bveenema/DAF021_ECM_3G-Hardware/DAF021_ECM_3G.kicad_pcb

## KiCad design DAF021_ECM_3G.kicad_pcb (2020-06-30)

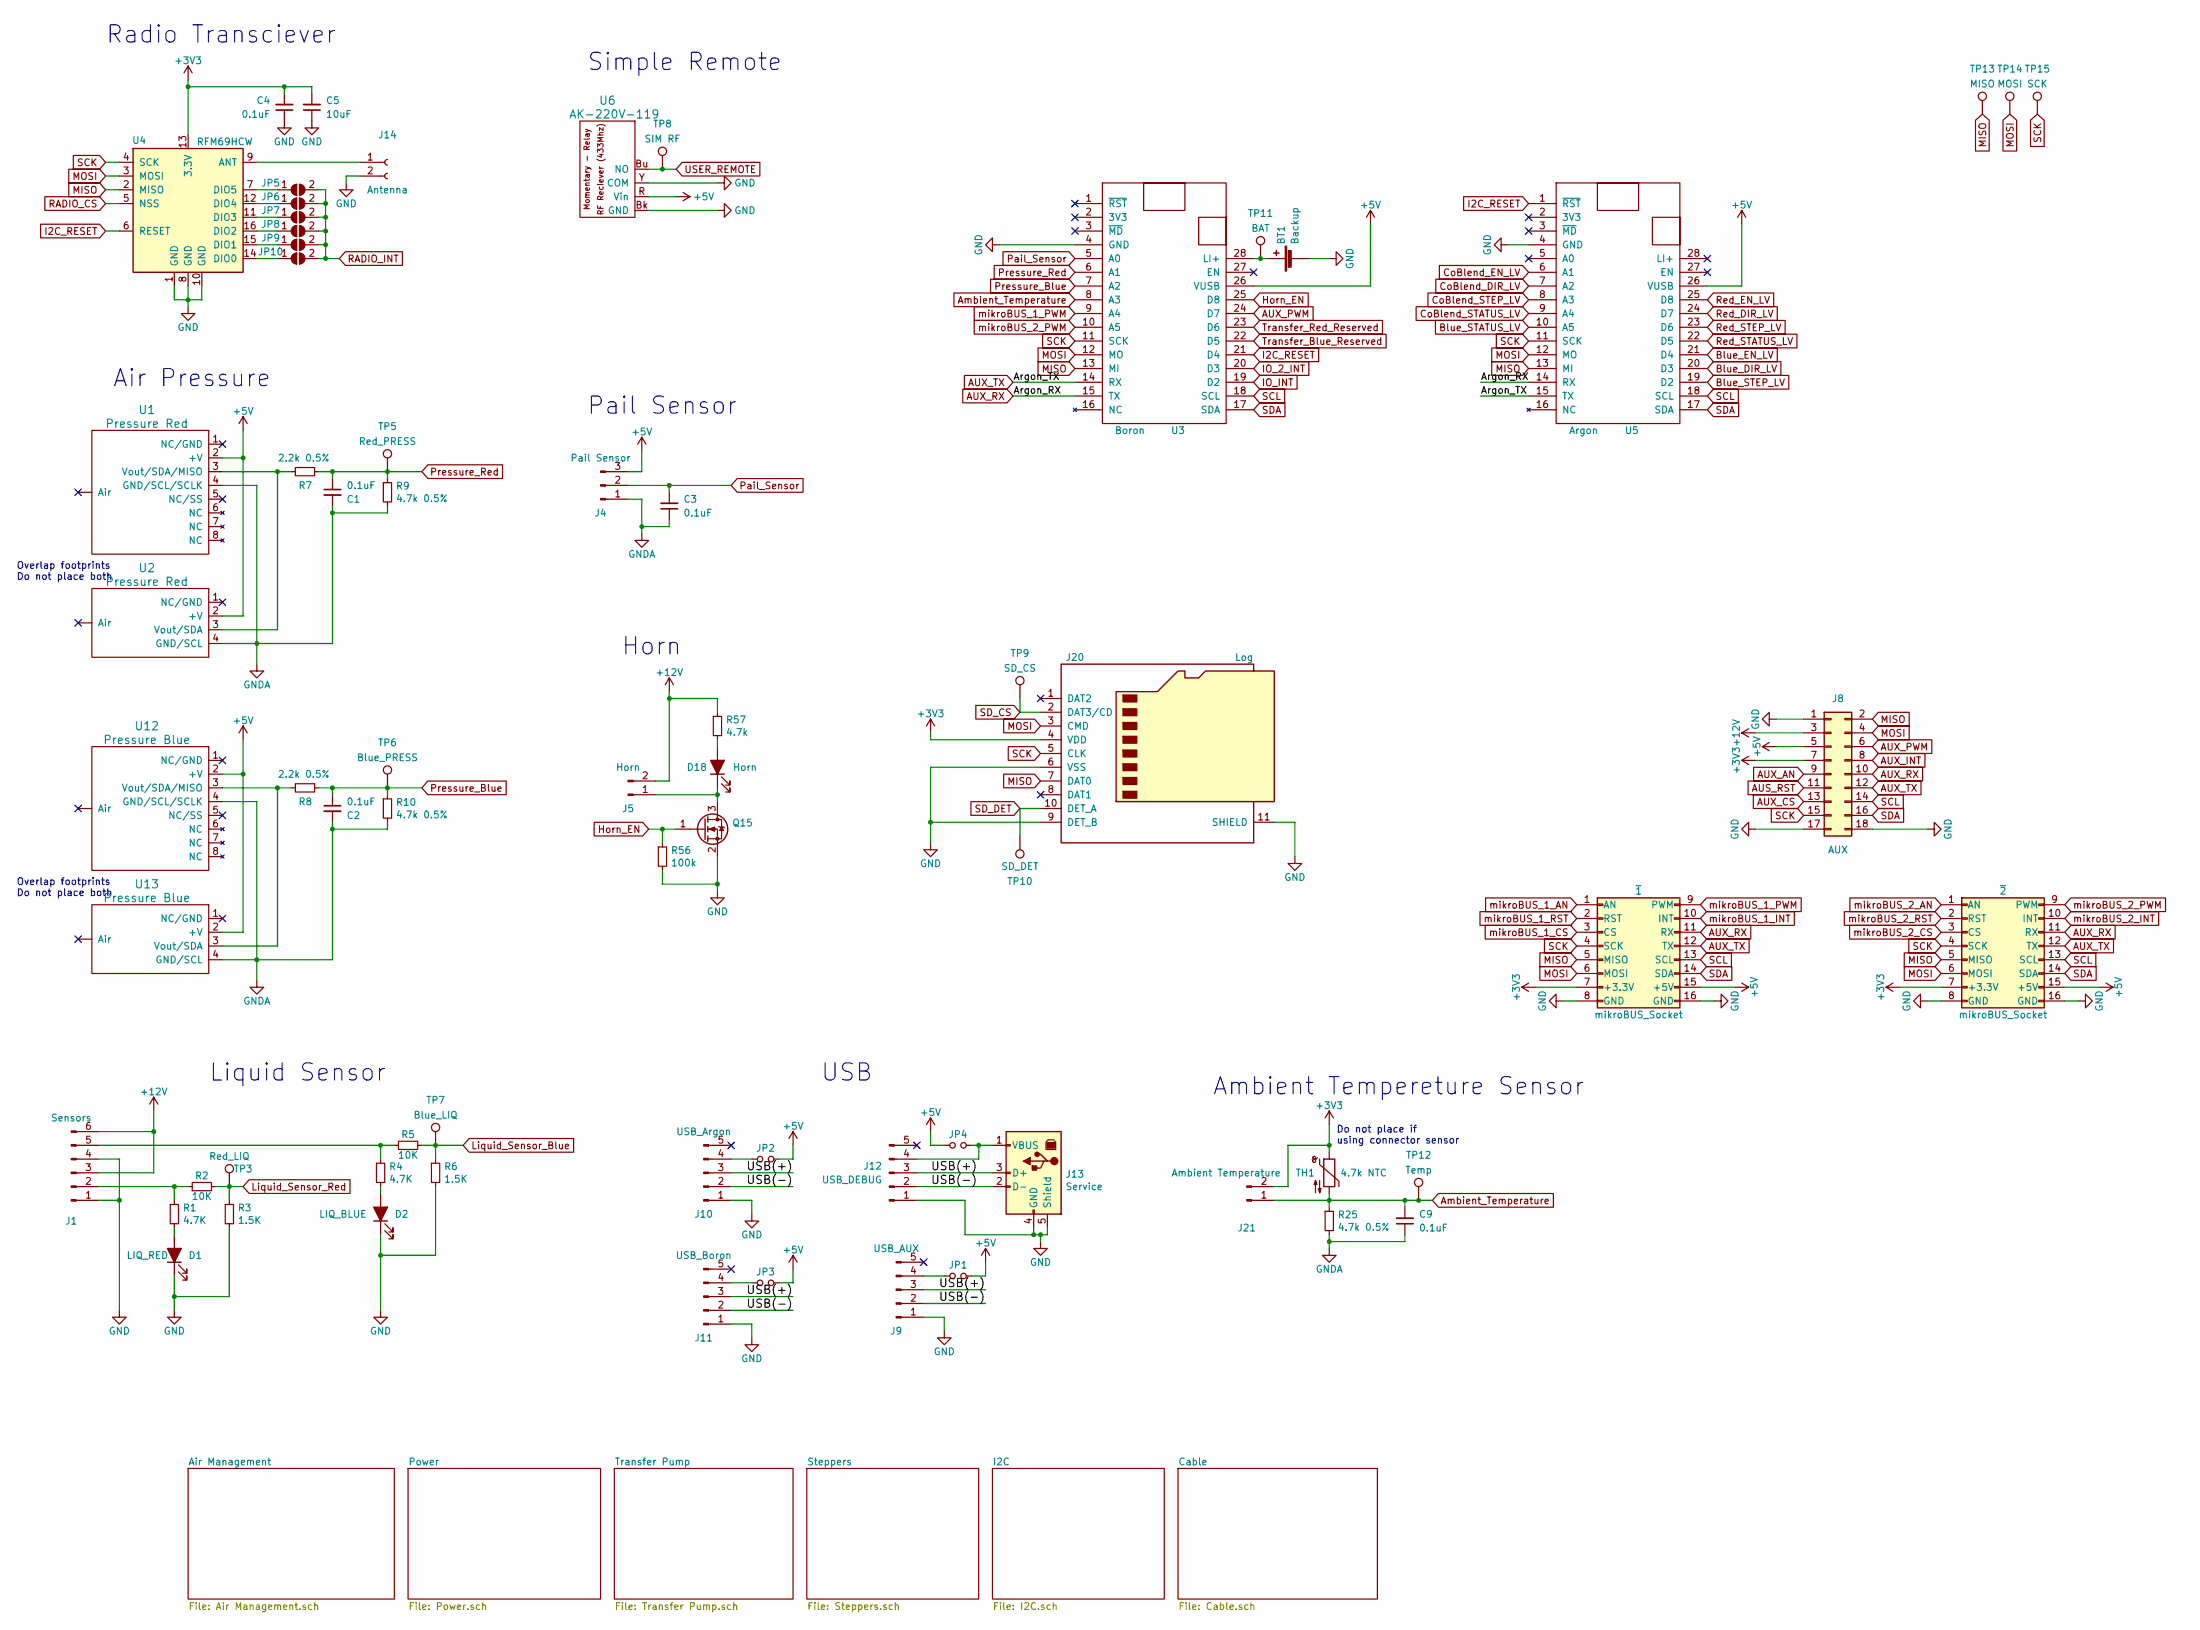
[picture p1: schematic DAF021_ECM_3G.sch]

Parts:
BT1: Backup; BatteryHolder_Keystone_1042_1x18650; MPN 1042
C1, C2, C3, C4, C9: 0.1uF; C_0805_2012Metric_Pad1.15x1.40mm_HandSolder; MPN CL21B104KCFWPNE
C5: 10uF; C_0805_2012Metric_Pad1.15x1.40mm_HandSolder; MPN CL21A106KOQNNNG
D1: LIQ_RED; LED_0805_2012Metric_Pad1.15x1.40mm_HandSolder; MPN 150080GS75000
D2: LIQ_BLUE; LED_0805_2012Metric_Pad1.15x1.40mm_HandSolder; MPN 150080GS75000
D18: Horn; LED_0805_2012Metric_Pad1.15x1.40mm_HandSolder; MPN 150080GS75000
J1: Sensors; JST_XH_B6B-XH-AM_1x06_P2.50mm_Vertical; MPN B6B-XH-AM(LF)(SN)
J4: Pail Sensor; JST_XH_B3B-XH-AM_1x03_P2.50mm_Vertical; MPN B3B-XH-AM(LF)(SN)
J5: Horn; JST_XH_B2B-XH-AM_1x02_P2.50mm_Vertical; MPN B2B-XH-A(LF)(SN)
J8: AUX; JST_XAD_B18B-XADSS-N-A_2x09_P2.50mm_Vertical; MPN B18B-XADSS-N(LF)(SN)
J9: USB_AUX; JST_XH_B5B-XH-AM_1x05_P2.50mm_Vertical; MPN B5B-XH-AM(LF)(SN)
J10: USB_Argon; JST_XH_B5B-XH-AM_1x05_P2.50mm_Vertical; MPN B5B-XH-AM(LF)(SN)
J11: USB_Boron; JST_XH_B5B-XH-AM_1x05_P2.50mm_Vertical; MPN B5B-XH-AM(LF)(SN)
J12: USB_DEBUG; JST_XH_B5B-XH-AM_1x05_P2.50mm_Vertical; MPN B5B-XH-AM(LF)(SN)
J13: Service; USB_B_Molex_67068-8000_Horizontal; MPN 0670688000
J14: Antenna; U.FL_Hirose_U.FL-R-SMT-1_Vertical; MPN U.FL-R-SMT-1(01)
J20: Log; microSD_HC_Hirose_DM3D-SF; MPN DM3D-SF
J21: Ambient Temperature; JST_XH_B2B-XH-AM_1x02_P2.50mm_Vertical; MPN B2B-XH-A(LF)(SN)
JP1, JP2, JP3, JP4, JP5, JP6, JP7, JP8, JP9, JP10: Jumper_NO_Small; SolderJumper-2_P1.3mm_Open_TrianglePad1.0x1.5mm; MPN N/A
Q15: Q_NMOS_GSD; SOT-23; MPN DMN3404L-7
R1, R4: 4.7K; R_0805_2012Metric_Pad1.15x1.40mm_HandSolder; MPN RMCF0805JT4K70
R2, R5: 10K; R_0805_2012Metric_Pad1.15x1.40mm_HandSolder; MPN RMCF0805JG10K0
R3, R6: 1.5K; R_0805_2012Metric_Pad1.15x1.40mm_HandSolder; MPN RMCF0805JT1K50
R7, R8: 2.2k 0.5%; R_0805_2012Metric_Pad1.15x1.40mm_HandSolder; MPN ERJ-PB6D2201V
R9, R10, R25: 4.7k 0.5%; R_0805_2012Metric_Pad1.15x1.40mm_HandSolder; MPN ERJ-PB6D4701V
R56: 100k; R_0805_2012Metric_Pad1.15x1.40mm_HandSolder; MPN RMCF0805JT100K
R57: 4.7k; R_0805_2012Metric_Pad1.15x1.40mm_HandSolder; MPN RMCF0805JT4K70
TH1: 4.7k NTC; R_0805_2012Metric_Pad1.15x1.40mm_HandSolder; MPN NTCS0805E3472FMT
TP3: Red_LIQ; TestPoint_THTPad_D1.5mm_Drill0.7mm
TP5: Red_PRESS; TestPoint_THTPad_D1.5mm_Drill0.7mm
TP6: Blue_PRESS; TestPoint_THTPad_D1.5mm_Drill0.7mm
TP7: Blue_LIQ; TestPoint_THTPad_D1.5mm_Drill0.7mm
TP8: SIM RF; TestPoint_THTPad_D1.5mm_Drill0.7mm
TP9: SD_CS; TestPoint_THTPad_D1.5mm_Drill0.7mm
TP10: SD_DET; TestPoint_THTPad_D1.5mm_Drill0.7mm
TP11: BAT; TestPoint_THTPad_D1.5mm_Drill0.7mm
TP12: Temp; TestPoint_THTPad_D1.5mm_Drill0.7mm
TP13: MISO; TestPoint_THTPad_D1.5mm_Drill0.7mm
TP14: MOSI; TestPoint_THTPad_D1.5mm_Drill0.7mm
TP15: SCK; TestPoint_THTPad_D1.5mm_Drill0.7mm
U1: Pressure Red; HoneyWell_DIP_AN; MPN HSCDANN005PGAA5
U2: Pressure Red; HoneyWell_SIP_NB; MPN HSCSNBN005PGAA5
U3: Boron; Argon_Boron_Xenon; MPN BRN402
U4: RFM69HCW; HOPERF_RFM69HCW; MPN COM-13910
U5: Argon; Argon_Boron_Xenon; MPN ARGN-H
U6: AK-220V-119; MPN AK-220V-119
U12: Pressure Blue; HoneyWell_DIP_AN; MPN HSCDANN005PGAA5
U13: Pressure Blue; HoneyWell_SIP_NB; MPN HSCSNBN005PGAA5
~1, ~2: mikroBUS_Socket; mikroBUS_Standard_Large; MPN PPTC081LFBN-RC

Connections:
+5V: J4.3, J8.5, JP1.1, JP2.1, JP3.1, JP4.1, U1.2 (+V), U2.2 (+V), U3.26 (VUSB), U5.26 (VUSB), U6.R (Vin), U12.2 (+V), U13.2 (+V), ~1.15 (+5V), ~2.15 (+5V); also elsewhere on the board
+12V: J1.3, J1.6, J5.2, J8.3, R57.1; also elsewhere on the board
/USB(+): J9.3, J10.3, J11.3, J12.3, J13.3 (D+)
/USB(-): J9.2, J10.2, J11.2, J12.2, J13.2 (D-)
AUS_RST: J8.11; also elsewhere on the board
AUX_AN: J8.9; also elsewhere on the board
AUX_CS: J8.13; also elsewhere on the board
AUX_INT: J8.8; also elsewhere on the board
AUX_PWM: J8.6, U3.24 (D7)
AUX_RX: J8.10, U3.15 (TX), U5.14 (RX), ~1.11 (RX), ~2.11 (RX)
AUX_TX: J8.12, U3.14 (RX), U5.15 (TX), ~1.12 (TX), ~2.12 (TX)
Ambient_Temperature: C9.2, J21.1, R25.1, TH1.2, TP12.1, U3.8 (A3)
Blue_DIR_LV: U5.20 (D3); also elsewhere on the board
Blue_EN_LV: U5.21 (D4); also elsewhere on the board
Blue_STATUS_LV: U5.10 (A5); also elsewhere on the board
Blue_STEP_LV: U5.19 (D2); also elsewhere on the board
CoBlend_DIR_LV: U5.7 (A2); also elsewhere on the board
CoBlend_EN_LV: U5.6 (A1); also elsewhere on the board
CoBlend_STATUS_LV: U5.9 (A4); also elsewhere on the board
CoBlend_STEP_LV: U5.8 (A3); also elsewhere on the board
GND: BT1.2 (-), C4.1, C5.1, D1.1 (K), D2.1 (K), J1.1, J1.4, J8.1, J8.17, J8.18, J9.1, J10.1, J11.1, J12.1, J13.4 (GND), J13.5 (Shield), J14.2, J20.6 (VSS), J20.9 (DET_B), J20.11 (SHIELD), Q15.2 (S), R3.2, R6.2, R56.2, U3.4 (GND), U4.1 (GND), U4.8 (GND), U4.10 (GND), U5.4 (GND), U6.Bk (GND), U6.Y (COM), ~1.8 (GND), ~1.16 (GND), ~2.8 (GND), ~2.16 (GND); also elsewhere on the board
GNDA: C1.2, C2.2, C3.1, C9.1, J4.1, R9.2, R10.2, R25.2, U1.4 (GND/SCL/SCLK), U2.4 (GND/SCL), U12.4 (GND/SCL/SCLK), U13.4 (GND/SCL); also elsewhere on the board
Horn_EN: Q15.1 (G), R56.1, U3.25 (D8)
I2C_RESET: U3.21 (D4), U4.6 (RESET), U5.1 (~RST); also elsewhere on the board
IO_2_INT: U3.20 (D3); also elsewhere on the board
IO_INT: U3.19 (D2); also elsewhere on the board
Liquid_Sensor_Blue: R5.2, R6.1, TP7.1; also elsewhere on the board
Liquid_Sensor_Red: R2.2, R3.1, TP3.1; also elsewhere on the board
MISO: J8.2, J20.7 (DAT0), TP13.1, U3.13 (MI), U4.2 (MISO), U5.13 (MI), ~1.5 (MISO), ~2.5 (MISO)
MOSI: J8.4, J20.3 (CMD), TP14.1, U3.12 (MO), U4.3 (MOSI), U5.12 (MO), ~1.6 (MOSI), ~2.6 (MOSI)
unnamed: BT1.1 (+), TP11.1, U3.28 (LI+)
unnamed: D1.2 (A), R1.2
unnamed: D2.2 (A), R4.2
unnamed: D18.1 (K), J5.1, Q15.3 (D)
unnamed: D18.2 (A), R57.2
unnamed: J1.2, R1.1, R2.1
unnamed: J1.5, R4.1, R5.1
unnamed: J9.4, JP1.2
unnamed: J10.4, JP2.2
unnamed: J11.4, JP3.2
unnamed: J12.4, J13.1 (VBUS), JP4.2
unnamed: J14.1, U4.9 (ANT)
unnamed: JP5.1 (A), U4.7 (DIO5)
unnamed: JP6.1 (A), U4.12 (DIO4)
unnamed: JP7.1 (A), U4.11 (DIO3)
unnamed: JP8.1 (A), U4.16 (DIO2)
unnamed: JP9.1 (A), U4.15 (DIO1)
unnamed: JP10.1 (A), U4.14 (DIO0)
unnamed: R7.2, U1.3 (Vout/SDA/MISO), U2.3 (Vout/SDA)
unnamed: R8.2, U12.3 (Vout/SDA/MISO), U13.3 (Vout/SDA)
Pail_Sensor: C3.2, J4.2, U3.5 (A0)
Pressure_Blue: C2.1, R8.1, R10.1, TP6.1, U3.7 (A2)
Pressure_Red: C1.1, R7.1, R9.1, TP5.1, U3.6 (A1)
RADIO_CS: U4.5 (NSS); also elsewhere on the board
RADIO_INT: JP5.2 (B), JP6.2 (B), JP7.2 (B), JP8.2 (B), JP9.2 (B), JP10.2 (B); also elsewhere on the board
Red_DIR_LV: U5.24 (D7); also elsewhere on the board
Red_EN_LV: U5.25 (D8); also elsewhere on the board
Red_STATUS_LV: U5.22 (D5); also elsewhere on the board
Red_STEP_LV: U5.23 (D6); also elsewhere on the board
SCK: J8.15, J20.5 (CLK), TP15.1, U3.11 (SCK), U4.4 (SCK), U5.11 (SCK), ~1.4 (SCK), ~2.4 (SCK)
SCL: J8.14, U3.18 (SCL), U5.18 (SCL), ~1.13 (SCL), ~2.13 (SCL); also elsewhere on the board
SDA: J8.16, U3.17 (SDA), U5.17 (SDA), ~1.14 (SDA), ~2.14 (SDA); also elsewhere on the board
SD_CS: J20.2 (DAT3/CD), TP9.1; also elsewhere on the board
SD_DET: J20.10 (DET_A), TP10.1; also elsewhere on the board
Transfer_Blue_Reserved: U3.22 (D5); also elsewhere on the board
Transfer_Red_Reserved: U3.23 (D6); also elsewhere on the board
USER_REMOTE: TP8.1, U6.Bu (NO); also elsewhere on the board
mikroBUS_1_PWM: U3.9 (A4), ~1.9 (PWM)
mikroBUS_2_PWM: U3.10 (A5), ~2.9 (PWM)

Notes on the sheet:
Radio Transciever
USB
Pail Sensor
Simple Remote
Liquid Sensor
Air Pressure
Horn
Ambient Tempereture Sensor
Do not place if using connector sensor
Overlap footprints Do not place both

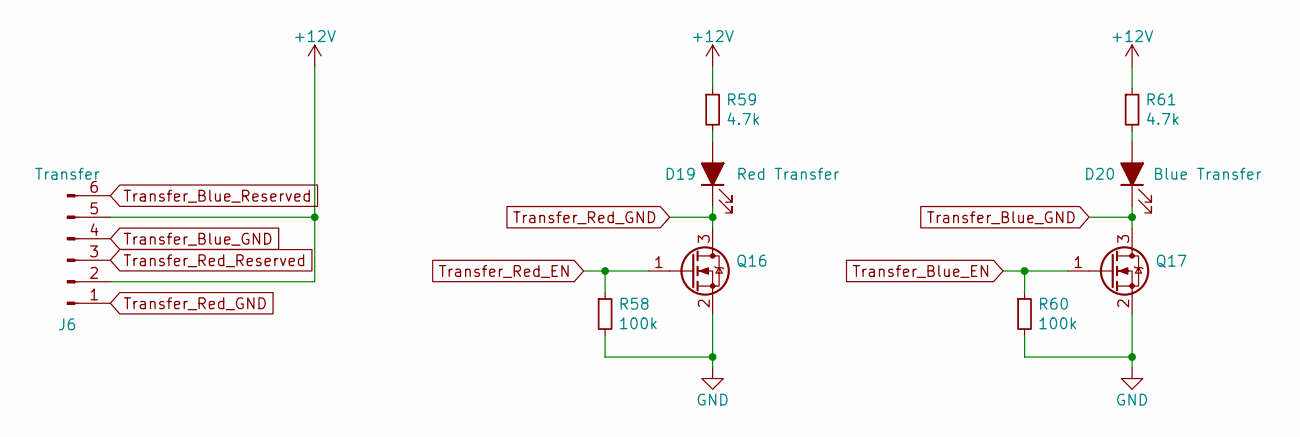
[picture p2: schematic Transfer Pump.sch]

Parts:
D19: Red Transfer; LED_0805_2012Metric_Pad1.15x1.40mm_HandSolder; MPN 150080GS75000
D20: Blue Transfer; LED_0805_2012Metric_Pad1.15x1.40mm_HandSolder; MPN 150080GS75000
J6: Transfer; JST_XH_B6B-XH-AM_1x06_P2.50mm_Vertical; MPN B6B-XH-AM(LF)(SN)
Q16, Q17: Q_NMOS_GSD; SOT-23; MPN DMN3404L-7
R58, R60: 100k; R_0805_2012Metric_Pad1.15x1.40mm_HandSolder; MPN RMCF0805JT100K
R59, R61: 4.7k; R_0805_2012Metric_Pad1.15x1.40mm_HandSolder; MPN RMCF0805JT4K70

Connections:
+12V: J6.2, J6.5, R59.1, R61.1; also elsewhere on the board
GND: Q16.2 (S), Q17.2 (S), R58.2, R60.2; also elsewhere on the board
unnamed: D19.2 (A), R59.2
unnamed: D20.2 (A), R61.2
Transfer_Blue_EN: Q17.1 (G), R60.1; also elsewhere on the board
Transfer_Blue_GND: D20.1 (K), J6.4, Q17.3 (D)
Transfer_Blue_Reserved: J6.6; also elsewhere on the board
Transfer_Red_EN: Q16.1 (G), R58.1; also elsewhere on the board
Transfer_Red_GND: D19.1 (K), J6.1, Q16.3 (D)
Transfer_Red_Reserved: J6.3; also elsewhere on the board

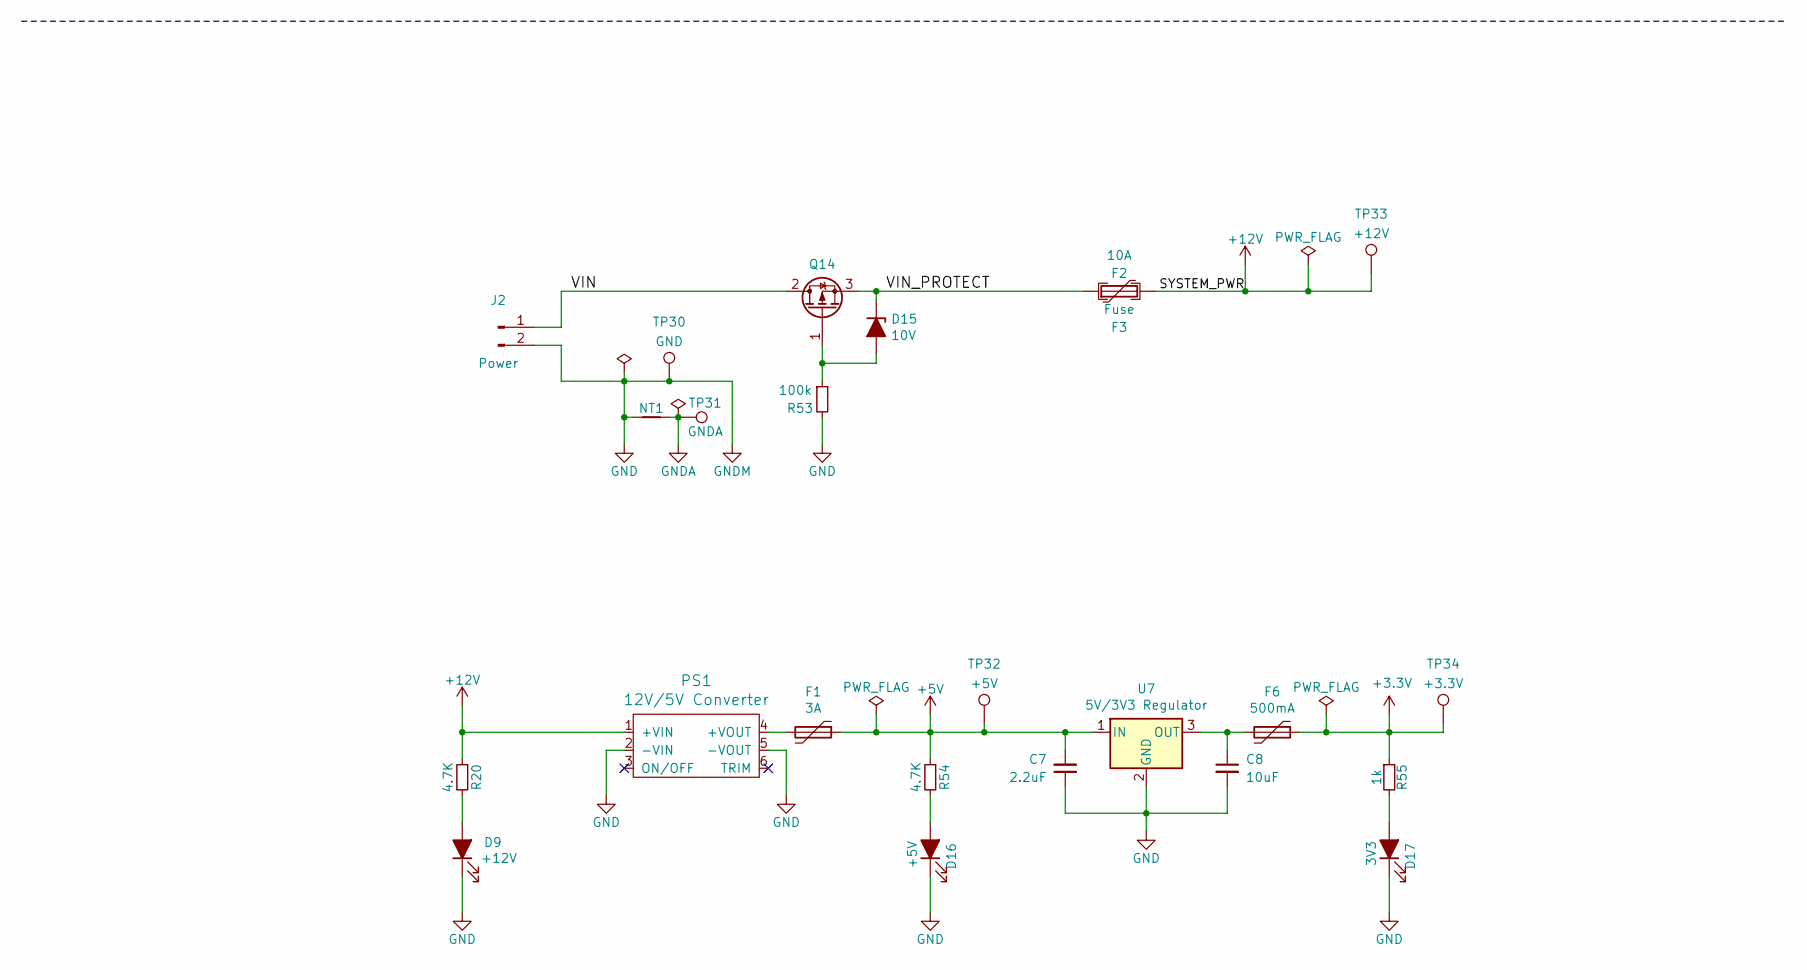
[picture p3: schematic Power.sch]

Parts:
C7: 2.2uF; C_0805_2012Metric_Pad1.15x1.40mm_HandSolder; MPN C0805C225K8RACTU
C8: 10uF; C_0805_2012Metric_Pad1.15x1.40mm_HandSolder; MPN CL21A106KOQNNNG
D9: +12V; LED_0805_2012Metric_Pad1.15x1.40mm_HandSolder; MPN 150080GS75000
D15: 10V; D_SMA; MPN SMAZ10-13-F
D16: +5V; LED_0805_2012Metric_Pad1.15x1.40mm_HandSolder; MPN 150080GS75000
D17: 3V3; LED_0805_2012Metric_Pad1.15x1.40mm_HandSolder; MPN 150080GS75000
F1: 3A; Fuse_2920_7451Metric_Pad2.10x5.45mm_HandSolder; MPN MF-LSMF300/24X-2
F2: 10A; NoFootprint; MPN BK/ABC-10-R
F3: Fuse; FUSE_HOLDER_.25inx1.25in_01220093Z; MPN 01220093Z
F6: 500mA; Fuse_0805_2012Metric_Pad1.15x1.40mm_HandSolder; MPN MF-PSMF050X-2
J2: Power; Molex_Sabre_43160-2102_1x02_P7.50mm_Vertical_ThermalVias; MPN 0431602102
NT1: Net-Tie_2; NetTie-2_SMD_Pad2.0mm
PS1: 12V/5V Converter; MeanWell_Power_Supply_2x1in_Shielded; MPN SKM30A-05
Q14: Q_PMOS_GDS; TO-263-3_TabPin2; MPN IRF5210STRLPBF
R20, R54: 4.7K; R_0805_2012Metric_Pad1.15x1.40mm_HandSolder; MPN RMCF0805JT4K70
R53: 100k; R_0805_2012Metric_Pad1.15x1.40mm_HandSolder; MPN RMCF0805JT100K
R55: 1k; R_0805_2012Metric_Pad1.15x1.40mm_HandSolder; MPN RNCP0805FTD1K00
TP30: GND; TestPoint_THTPad_D1.5mm_Drill0.7mm
TP31: GNDA; TestPoint_THTPad_D1.5mm_Drill0.7mm
TP32: +5V; TestPoint_THTPad_D1.5mm_Drill0.7mm
TP33: +12V; TestPoint_THTPad_D1.5mm_Drill0.7mm
TP34: +3.3V; TestPoint_THTPad_D1.5mm_Drill0.7mm
U7: 5V/3V3 Regulator; TO-220F-3_Vertical; MPN MEZD71201A-F

Connections:
+5V: C7.2, F1.1, R54.1, TP32.1, U7.1 (IN); also elsewhere on the board
+12V: F3.2, PS1.1 (+VIN), R20.1, TP33.1; also elsewhere on the board
/Power/VIN: J2.1, Q14.2 (D)
/Power/VIN_PROTECT: D15.1 (K), F3.1, Q14.3 (S)
GND: C7.1, C8.2, D9.1 (K), D16.1 (K), D17.1 (K), J2.2, NT1.1, PS1.2 (-VIN), PS1.5 (-VOUT), R53.2, TP30.1, U7.2 (GND); also elsewhere on the board
GNDA: NT1.2, TP31.1; also elsewhere on the board
unnamed: C8.1, F6.2, U7.3 (OUT)
unnamed: D9.2 (A), R20.2
unnamed: D15.2 (A), Q14.1 (G), R53.1
unnamed: D16.2 (A), R54.2
unnamed: D17.2 (A), R55.2
unnamed: F1.2, PS1.4 (+VOUT)

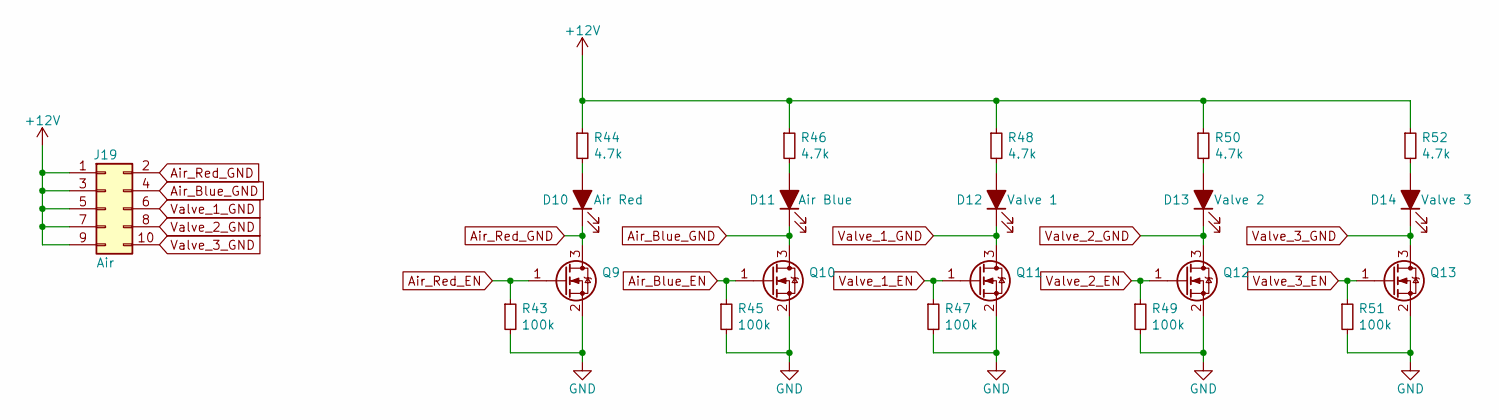
[picture p4: schematic Air Management.sch]

Parts:
D10: Air Red; LED_0805_2012Metric_Pad1.15x1.40mm_HandSolder; MPN 150080GS75000
D11: Air Blue; LED_0805_2012Metric_Pad1.15x1.40mm_HandSolder; MPN 150080GS75000
D12: Valve 1; LED_0805_2012Metric_Pad1.15x1.40mm_HandSolder; MPN 150080GS75000
D13: Valve 2; LED_0805_2012Metric_Pad1.15x1.40mm_HandSolder; MPN 150080GS75000
D14: Valve 3; LED_0805_2012Metric_Pad1.15x1.40mm_HandSolder; MPN 150080GS75000
J19: Air; JST_XAD_B10B-XADSS-N-A_2x05_P2.50mm_Vertical; MPN B10B-XADSS-N(LF)(SN)
Q9, Q10, Q11, Q12, Q13: Q_NMOS_GSD; SOT-23; MPN DMN3404L-7
R43, R45, R47, R49, R51: 100k; R_0805_2012Metric_Pad1.15x1.40mm_HandSolder; MPN RMCF0805JT100K
R44, R46, R48, R50, R52: 4.7k; R_0805_2012Metric_Pad1.15x1.40mm_HandSolder; MPN RMCF0805JT4K70

Connections:
+12V: J19.1, J19.3, J19.5, J19.7, J19.9, R44.1, R46.1, R48.1, R50.1, R52.1; also elsewhere on the board
Air_Blue_EN: Q10.1 (G), R45.1; also elsewhere on the board
Air_Blue_GND: D11.1 (K), J19.4, Q10.3 (D)
Air_Red_EN: Q9.1 (G), R43.1; also elsewhere on the board
Air_Red_GND: D10.1 (K), J19.2, Q9.3 (D)
GND: Q9.2 (S), Q10.2 (S), Q11.2 (S), Q12.2 (S), Q13.2 (S), R43.2, R45.2, R47.2, R49.2, R51.2; also elsewhere on the board
unnamed: D10.2 (A), R44.2
unnamed: D11.2 (A), R46.2
unnamed: D12.2 (A), R48.2
unnamed: D13.2 (A), R50.2
unnamed: D14.2 (A), R52.2
Valve_1_EN: Q11.1 (G), R47.1; also elsewhere on the board
Valve_1_GND: D12.1 (K), J19.6, Q11.3 (D)
Valve_2_EN: Q12.1 (G), R49.1; also elsewhere on the board
Valve_2_GND: D13.1 (K), J19.8, Q12.3 (D)
Valve_3_EN: Q13.1 (G), R51.1; also elsewhere on the board
Valve_3_GND: D14.1 (K), J19.10, Q13.3 (D)

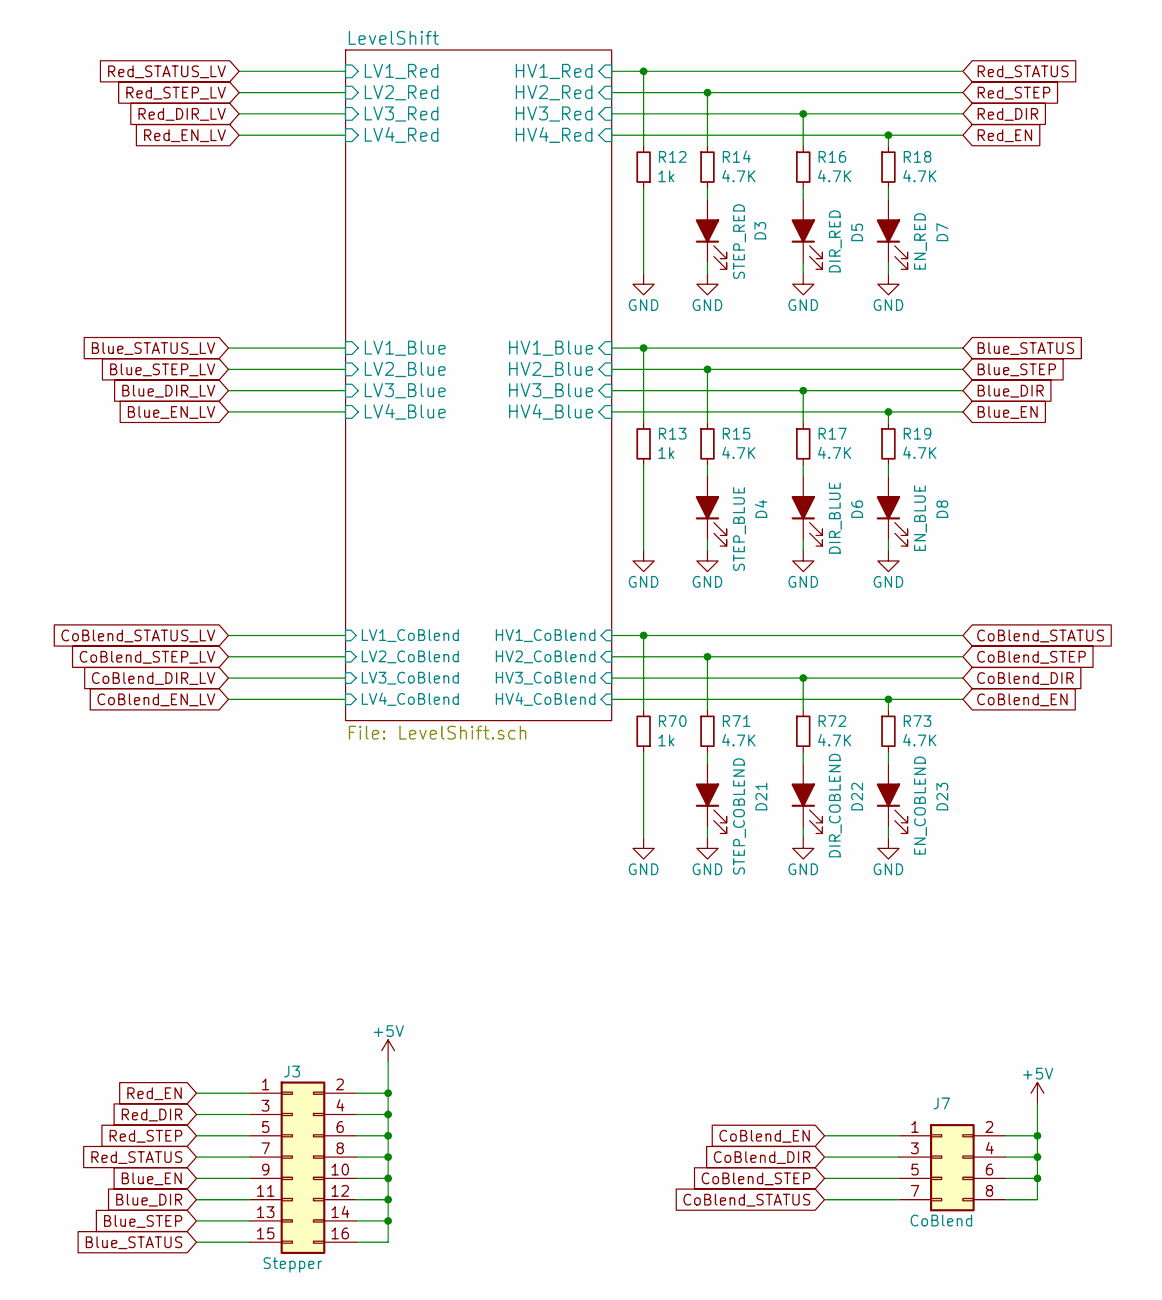
[picture p5: schematic Steppers.sch]

Parts:
D3: STEP_RED; LED_0805_2012Metric_Pad1.15x1.40mm_HandSolder; MPN 150080GS75000
D4: STEP_BLUE; LED_0805_2012Metric_Pad1.15x1.40mm_HandSolder; MPN 150080GS75000
D5: DIR_RED; LED_0805_2012Metric_Pad1.15x1.40mm_HandSolder; MPN 150080GS75000
D6: DIR_BLUE; LED_0805_2012Metric_Pad1.15x1.40mm_HandSolder; MPN 150080GS75000
D7: EN_RED; LED_0805_2012Metric_Pad1.15x1.40mm_HandSolder; MPN 150080GS75000
D8: EN_BLUE; LED_0805_2012Metric_Pad1.15x1.40mm_HandSolder; MPN 150080GS75000
D21: STEP_COBLEND; LED_0805_2012Metric_Pad1.15x1.40mm_HandSolder; MPN 150080GS75000
D22: DIR_COBLEND; LED_0805_2012Metric_Pad1.15x1.40mm_HandSolder; MPN 150080GS75000
D23: EN_COBLEND; LED_0805_2012Metric_Pad1.15x1.40mm_HandSolder; MPN 150080GS75000
J3: Stepper; JST_XAD_B16B-XADSS-N-A_2x08_P2.50mm_Vertical; MPN B16B-XADSS-N(LF)(SN)
J7: CoBlend; JST_XAD_B08B-XADSS-N-A_2x04_P2.50mm_Vertical; MPN B08B-XADSS-N(LF)(SN)
R12, R13, R70: 1k; R_0805_2012Metric_Pad1.15x1.40mm_HandSolder; MPN RNCP0805FTD1K00
R14, R15, R16, R17, R18, R19, R71, R72, R73: 4.7K; R_0805_2012Metric_Pad1.15x1.40mm_HandSolder; MPN RMCF0805JT4K70

Connections:
+5V: J3.2, J3.4, J3.6, J3.8, J3.10, J3.12, J3.14, J3.16, J7.2, J7.4, J7.6, J7.8; also elsewhere on the board
Blue_DIR: J3.11, R17.1; also elsewhere on the board
Blue_EN: J3.9, R19.1; also elsewhere on the board
Blue_STATUS: J3.15, R13.2; also elsewhere on the board
Blue_STEP: J3.13, R15.1; also elsewhere on the board
CoBlend_DIR: J7.3, R72.1; also elsewhere on the board
CoBlend_EN: J7.1, R73.1; also elsewhere on the board
CoBlend_STATUS: J7.7, R70.2; also elsewhere on the board
CoBlend_STEP: J7.5, R71.1; also elsewhere on the board
GND: D3.1 (K), D4.1 (K), D5.1 (K), D6.1 (K), D7.1 (K), D8.1 (K), D21.1 (K), D22.1 (K), D23.1 (K), R12.1, R13.1, R70.1; also elsewhere on the board
unnamed: D3.2 (A), R14.2
unnamed: D4.2 (A), R15.2
unnamed: D5.2 (A), R16.2
unnamed: D6.2 (A), R17.2
unnamed: D7.2 (A), R18.2
unnamed: D8.2 (A), R19.2
unnamed: D21.2 (A), R71.2
unnamed: D22.2 (A), R72.2
unnamed: D23.2 (A), R73.2
Red_DIR: J3.3, R16.1; also elsewhere on the board
Red_EN: J3.1, R18.1; also elsewhere on the board
Red_STATUS: J3.7, R12.2; also elsewhere on the board
Red_STEP: J3.5, R14.1; also elsewhere on the board

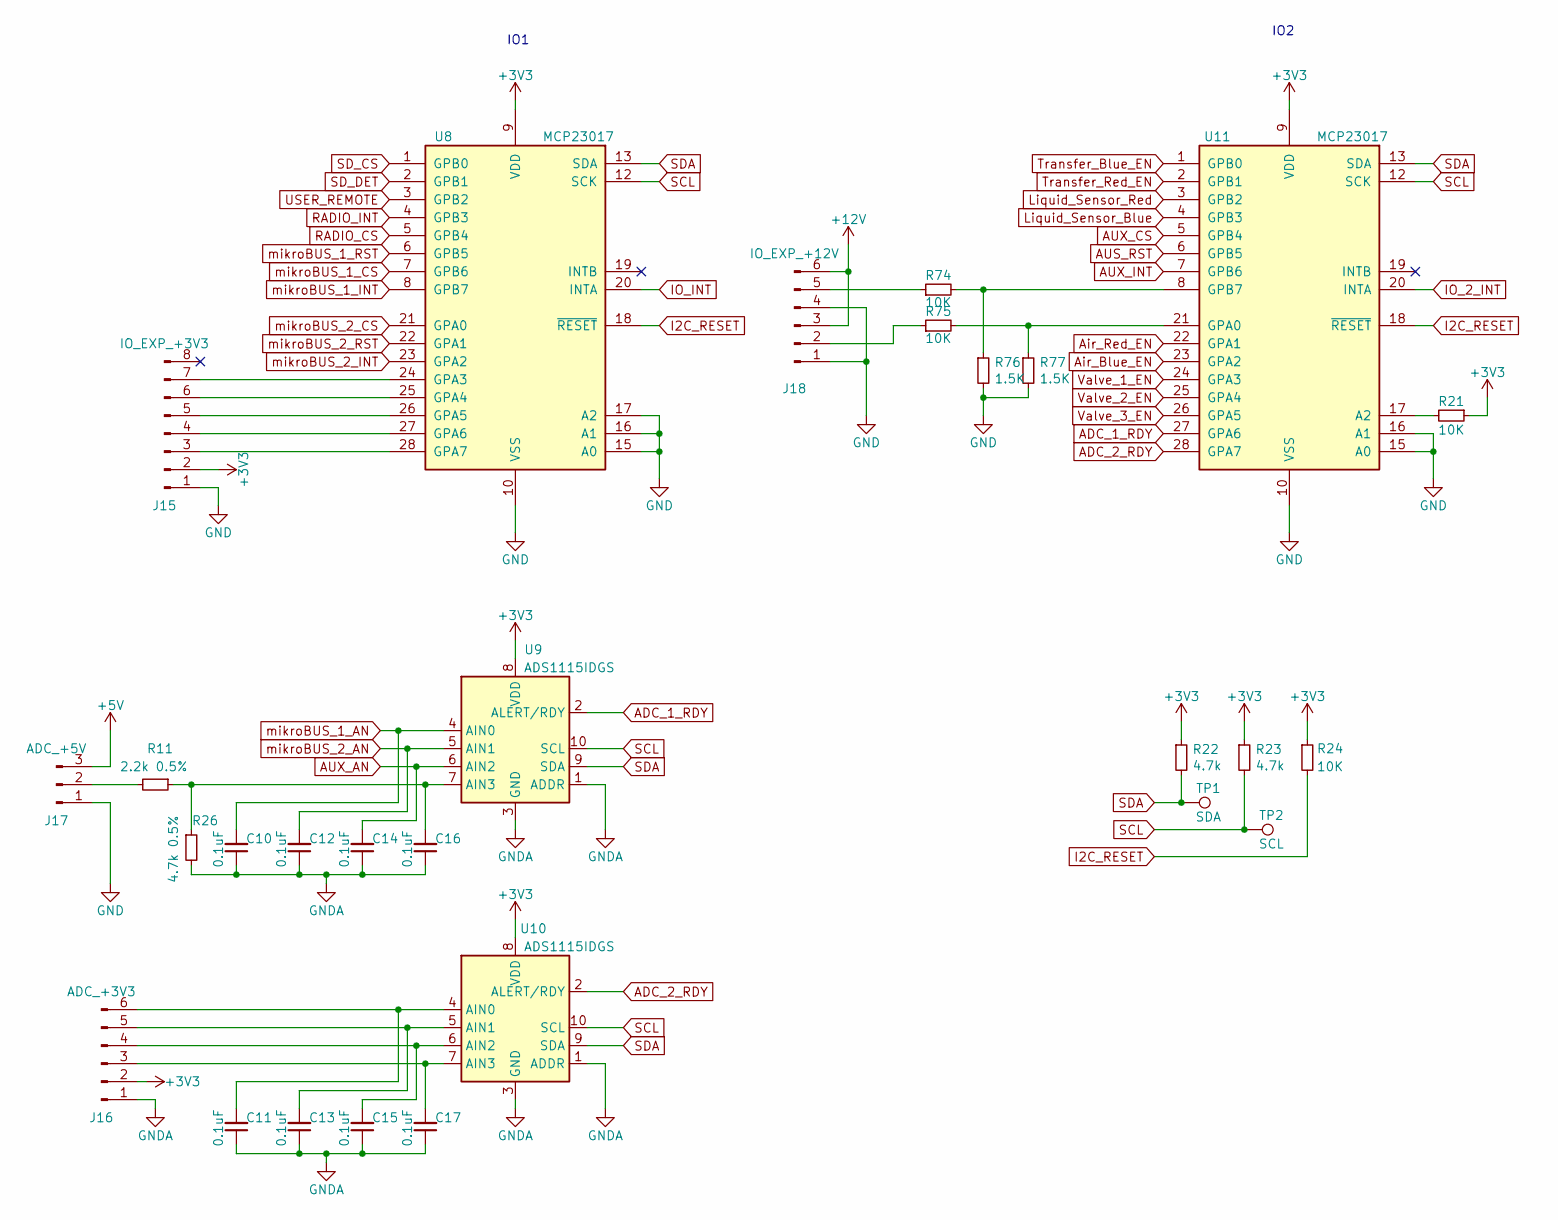
[picture p6: schematic I2C.sch]

Parts:
C10, C11, C12, C13, C14, C15, C16, C17: 0.1uF; C_0805_2012Metric_Pad1.15x1.40mm_HandSolder; MPN CL21B104KCFWPNE
J15: IO_EXP_+3V3; JST_XH_B8B-XH-AM_1x08_P2.50mm_Vertical; MPN B8B-XH-AM(LF)(SN)
J16: ADC_+3V3; JST_XH_B6B-XH-AM_1x06_P2.50mm_Vertical; MPN B6B-XH-AM(LF)(SN)
J17: ADC_+5V; JST_XH_B3B-XH-AM_1x03_P2.50mm_Vertical; MPN B3B-XH-AM(LF)(SN)
J18: IO_EXP_+12V; JST_XH_B6B-XH-AM_1x06_P2.50mm_Vertical; MPN B6B-XH-AM(LF)(SN)
R11: 2.2k 0.5%; R_0805_2012Metric_Pad1.15x1.40mm_HandSolder; MPN ERJ-PB6D2201V
R21, R24, R74, R75: 10K; R_0805_2012Metric_Pad1.15x1.40mm_HandSolder; MPN RMCF0805JG10K0
R22, R23: 4.7k; R_0805_2012Metric_Pad1.15x1.40mm_HandSolder; MPN RMCF0805JT4K70
R26: 4.7k 0.5%; R_0805_2012Metric_Pad1.15x1.40mm_HandSolder; MPN ERJ-PB6D4701V
R76, R77: 1.5K; R_0805_2012Metric_Pad1.15x1.40mm_HandSolder; MPN RMCF0805JT1K50
TP1: SDA; TestPoint_THTPad_D1.5mm_Drill0.7mm
TP2: SCL; TestPoint_THTPad_D1.5mm_Drill0.7mm
U8, U11: MCP23017; SOIC-28W_7.5x17.9mm_P1.27mm; MPN MCP23017T-E/SO
U9, U10: ADS1115IDGS; TSSOP-10_3x3mm_P0.5mm; MPN ADS1115IDGSR

Connections:
+5V: J17.3; also elsewhere on the board
+12V: J18.3, J18.6; also elsewhere on the board
ADC_1_RDY: U9.2 (ALERT/RDY), U11.27 (GPA6)
ADC_2_RDY: U10.2 (ALERT/RDY), U11.28 (GPA7)
AUS_RST: U11.6 (GPB5); also elsewhere on the board
AUX_AN: C14.2, U9.6 (AIN2); also elsewhere on the board
AUX_CS: U11.5 (GPB4); also elsewhere on the board
AUX_INT: U11.7 (GPB6); also elsewhere on the board
Air_Blue_EN: U11.23 (GPA2); also elsewhere on the board
Air_Red_EN: U11.22 (GPA1); also elsewhere on the board
GND: J15.1, J17.1, J18.1, J18.4, R76.2, R77.2, U8.10 (VSS), U8.15 (A0), U8.16 (A1), U8.17 (A2), U11.10 (VSS), U11.15 (A0), U11.16 (A1); also elsewhere on the board
GNDA: C10.1, C11.1, C12.1, C13.1, C14.1, C15.1, C16.1, C17.1, J16.1, R26.2, U9.1 (ADDR), U9.3 (GND), U10.1 (ADDR), U10.3 (GND); also elsewhere on the board
I2C_RESET: R24.2, U8.18 (~RESET~), U11.18 (~RESET~); also elsewhere on the board
IO_2_INT: U11.20 (INTA); also elsewhere on the board
IO_INT: U8.20 (INTA); also elsewhere on the board
Liquid_Sensor_Blue: U11.4 (GPB3); also elsewhere on the board
Liquid_Sensor_Red: U11.3 (GPB2); also elsewhere on the board
unnamed: C11.2, J16.6, U10.4 (AIN0)
unnamed: C13.2, J16.5, U10.5 (AIN1)
unnamed: C15.2, J16.4, U10.6 (AIN2)
unnamed: C16.2, R11.1, R26.1, U9.7 (AIN3)
unnamed: C17.2, J16.3, U10.7 (AIN3)
unnamed: J15.3, U8.28 (GPA7)
unnamed: J15.4, U8.27 (GPA6)
unnamed: J15.5, U8.26 (GPA5)
unnamed: J15.6, U8.25 (GPA4)
unnamed: J15.7, U8.24 (GPA3)
unnamed: J17.2, R11.2
unnamed: J18.2, R75.1
unnamed: J18.5, R74.1
unnamed: R21.2, U11.17 (A2)
unnamed: R74.2, R76.1, U11.8 (GPB7)
unnamed: R75.2, R77.1, U11.21 (GPA0)
RADIO_CS: U8.5 (GPB4); also elsewhere on the board
RADIO_INT: U8.4 (GPB3); also elsewhere on the board
SCL: R23.2, TP2.1, U8.12 (SCK), U9.10 (SCL), U10.10 (SCL), U11.12 (SCK); also elsewhere on the board
SDA: R22.2, TP1.1, U8.13 (SDA), U9.9 (SDA), U10.9 (SDA), U11.13 (SDA); also elsewhere on the board
SD_CS: U8.1 (GPB0); also elsewhere on the board
SD_DET: U8.2 (GPB1); also elsewhere on the board
Transfer_Blue_EN: U11.1 (GPB0); also elsewhere on the board
Transfer_Red_EN: U11.2 (GPB1); also elsewhere on the board
USER_REMOTE: U8.3 (GPB2); also elsewhere on the board
Valve_1_EN: U11.24 (GPA3); also elsewhere on the board
Valve_2_EN: U11.25 (GPA4); also elsewhere on the board
Valve_3_EN: U11.26 (GPA5); also elsewhere on the board
mikroBUS_1_AN: C10.2, U9.4 (AIN0)
mikroBUS_1_CS: U8.7 (GPB6)
mikroBUS_1_INT: U8.8 (GPB7)
mikroBUS_1_RST: U8.6 (GPB5)
mikroBUS_2_AN: C12.2, U9.5 (AIN1)
mikroBUS_2_CS: U8.21 (GPA0)
mikroBUS_2_INT: U8.23 (GPA2)
mikroBUS_2_RST: U8.22 (GPA1)

Notes on the sheet:
IO1
IO2
