bveenema/DAF021_ECM_3G-Hardware/DAF021_ECM_3G.kicad_pcb

## KiCad design DAF021_ECM_3G.kicad_pcb (continued)

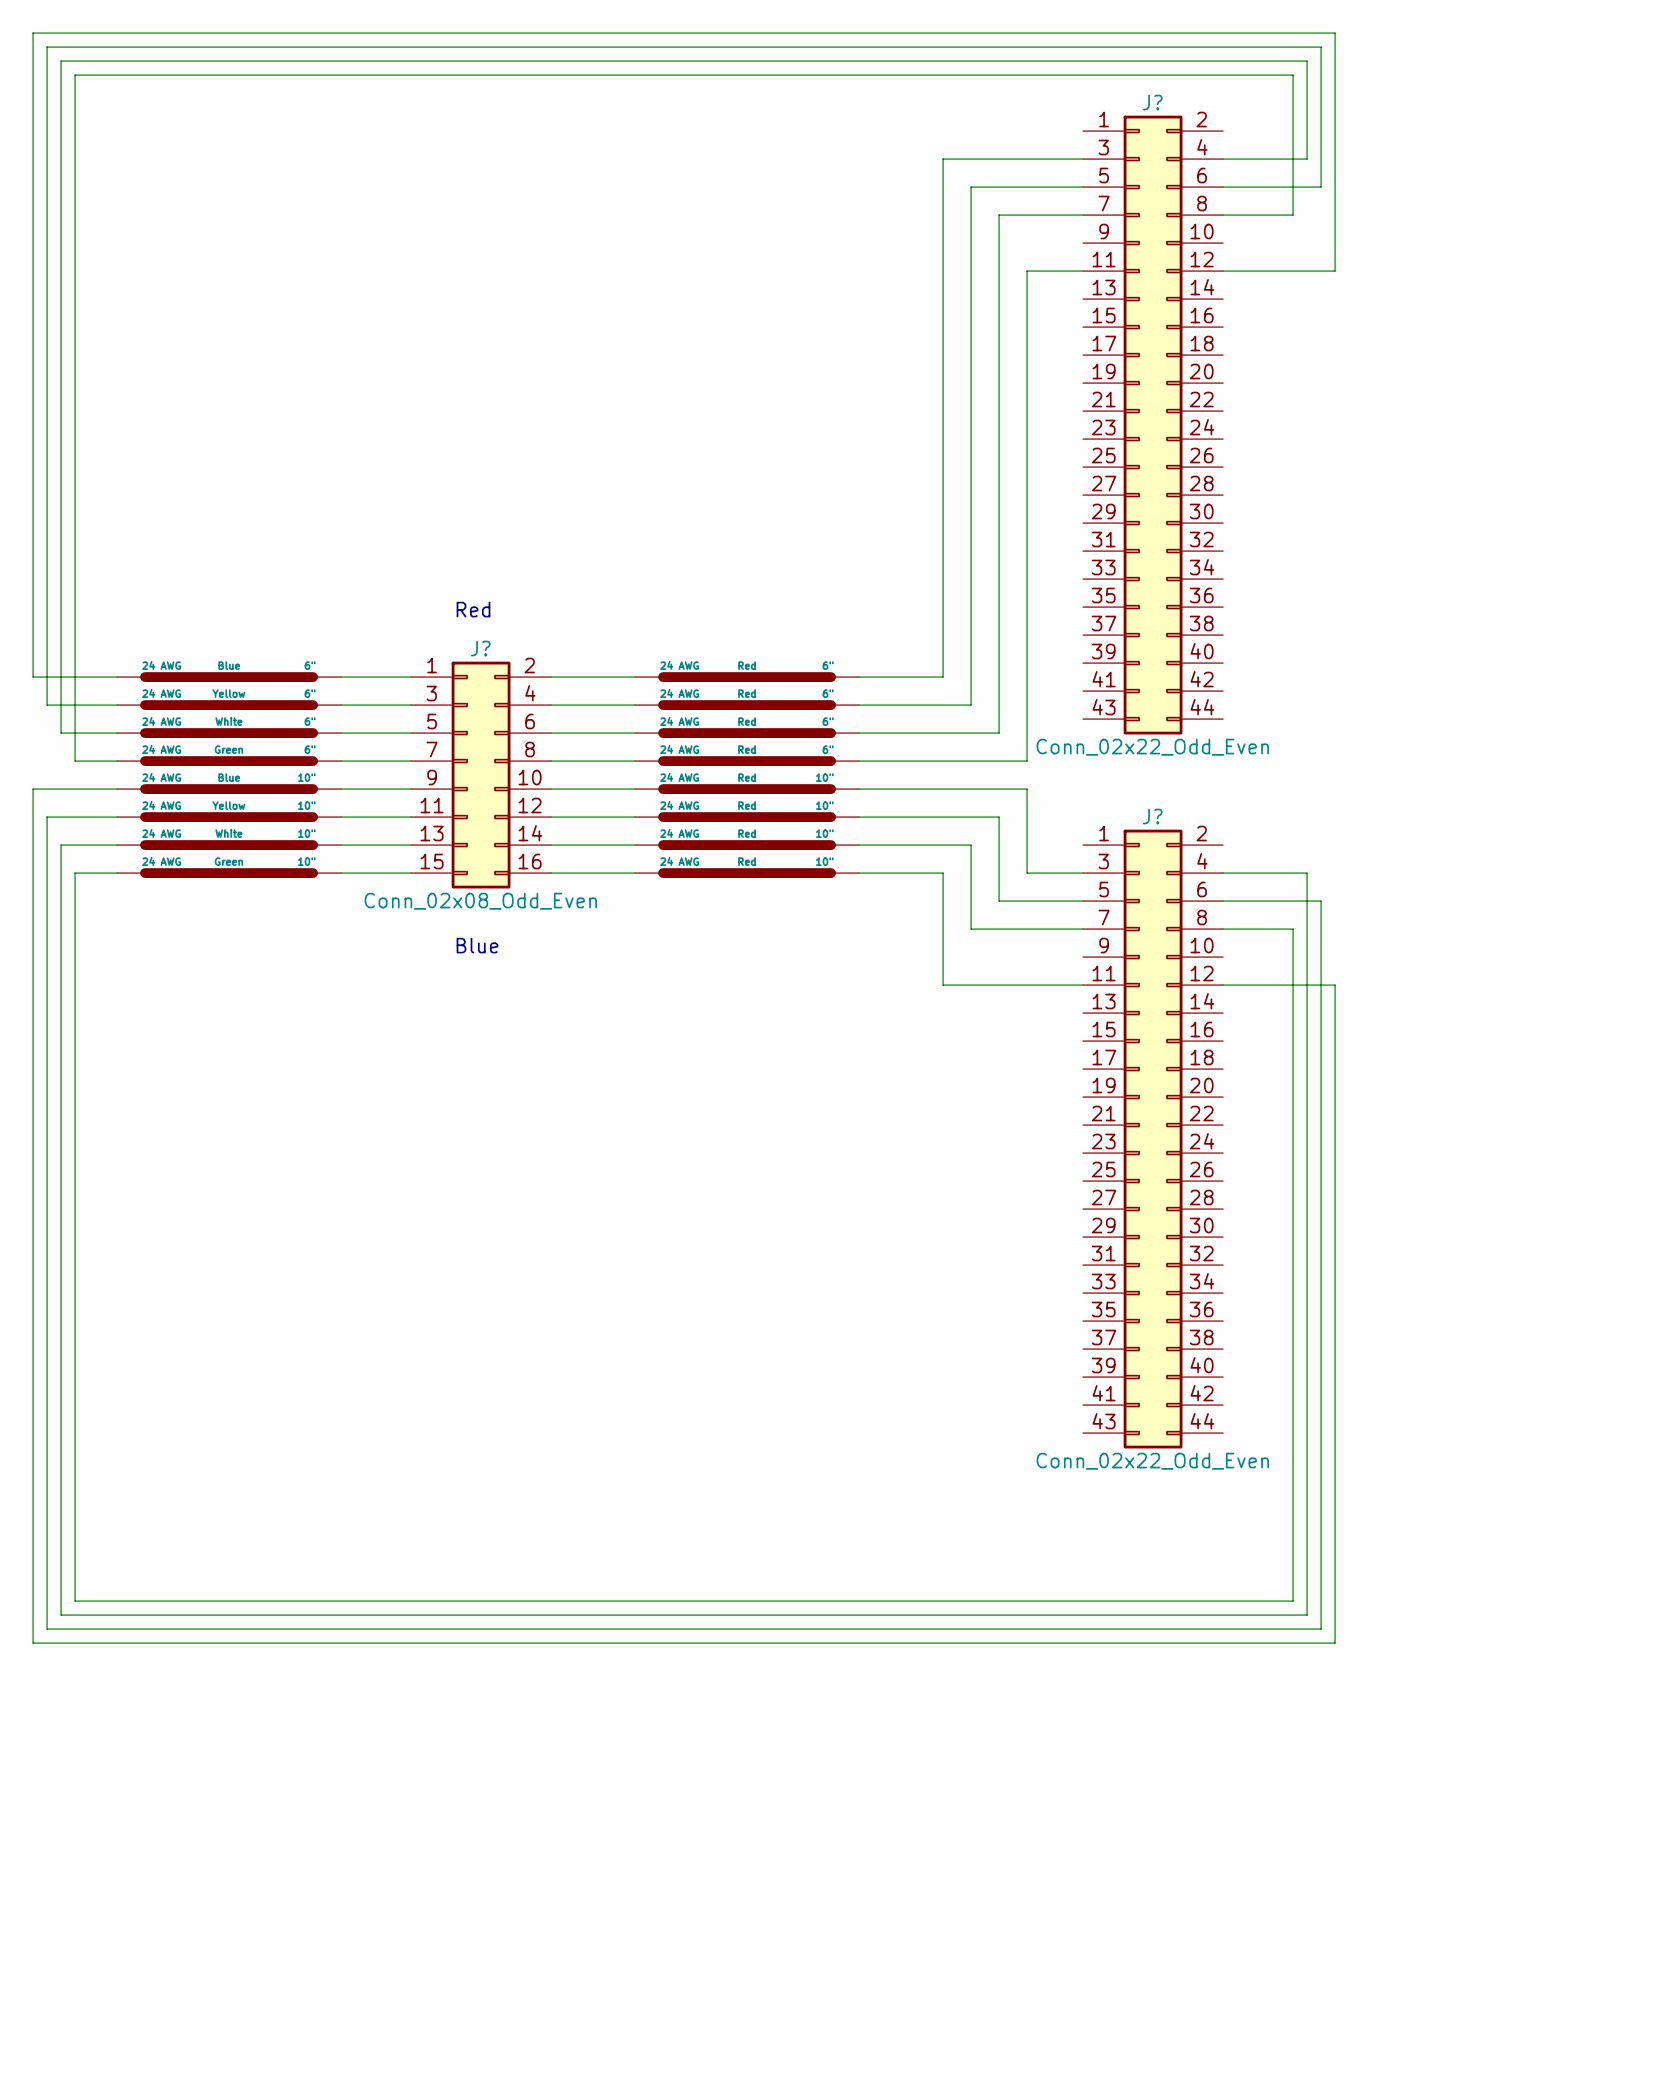
[picture p7: schematic Cable.sch, part in row 1, column 1]

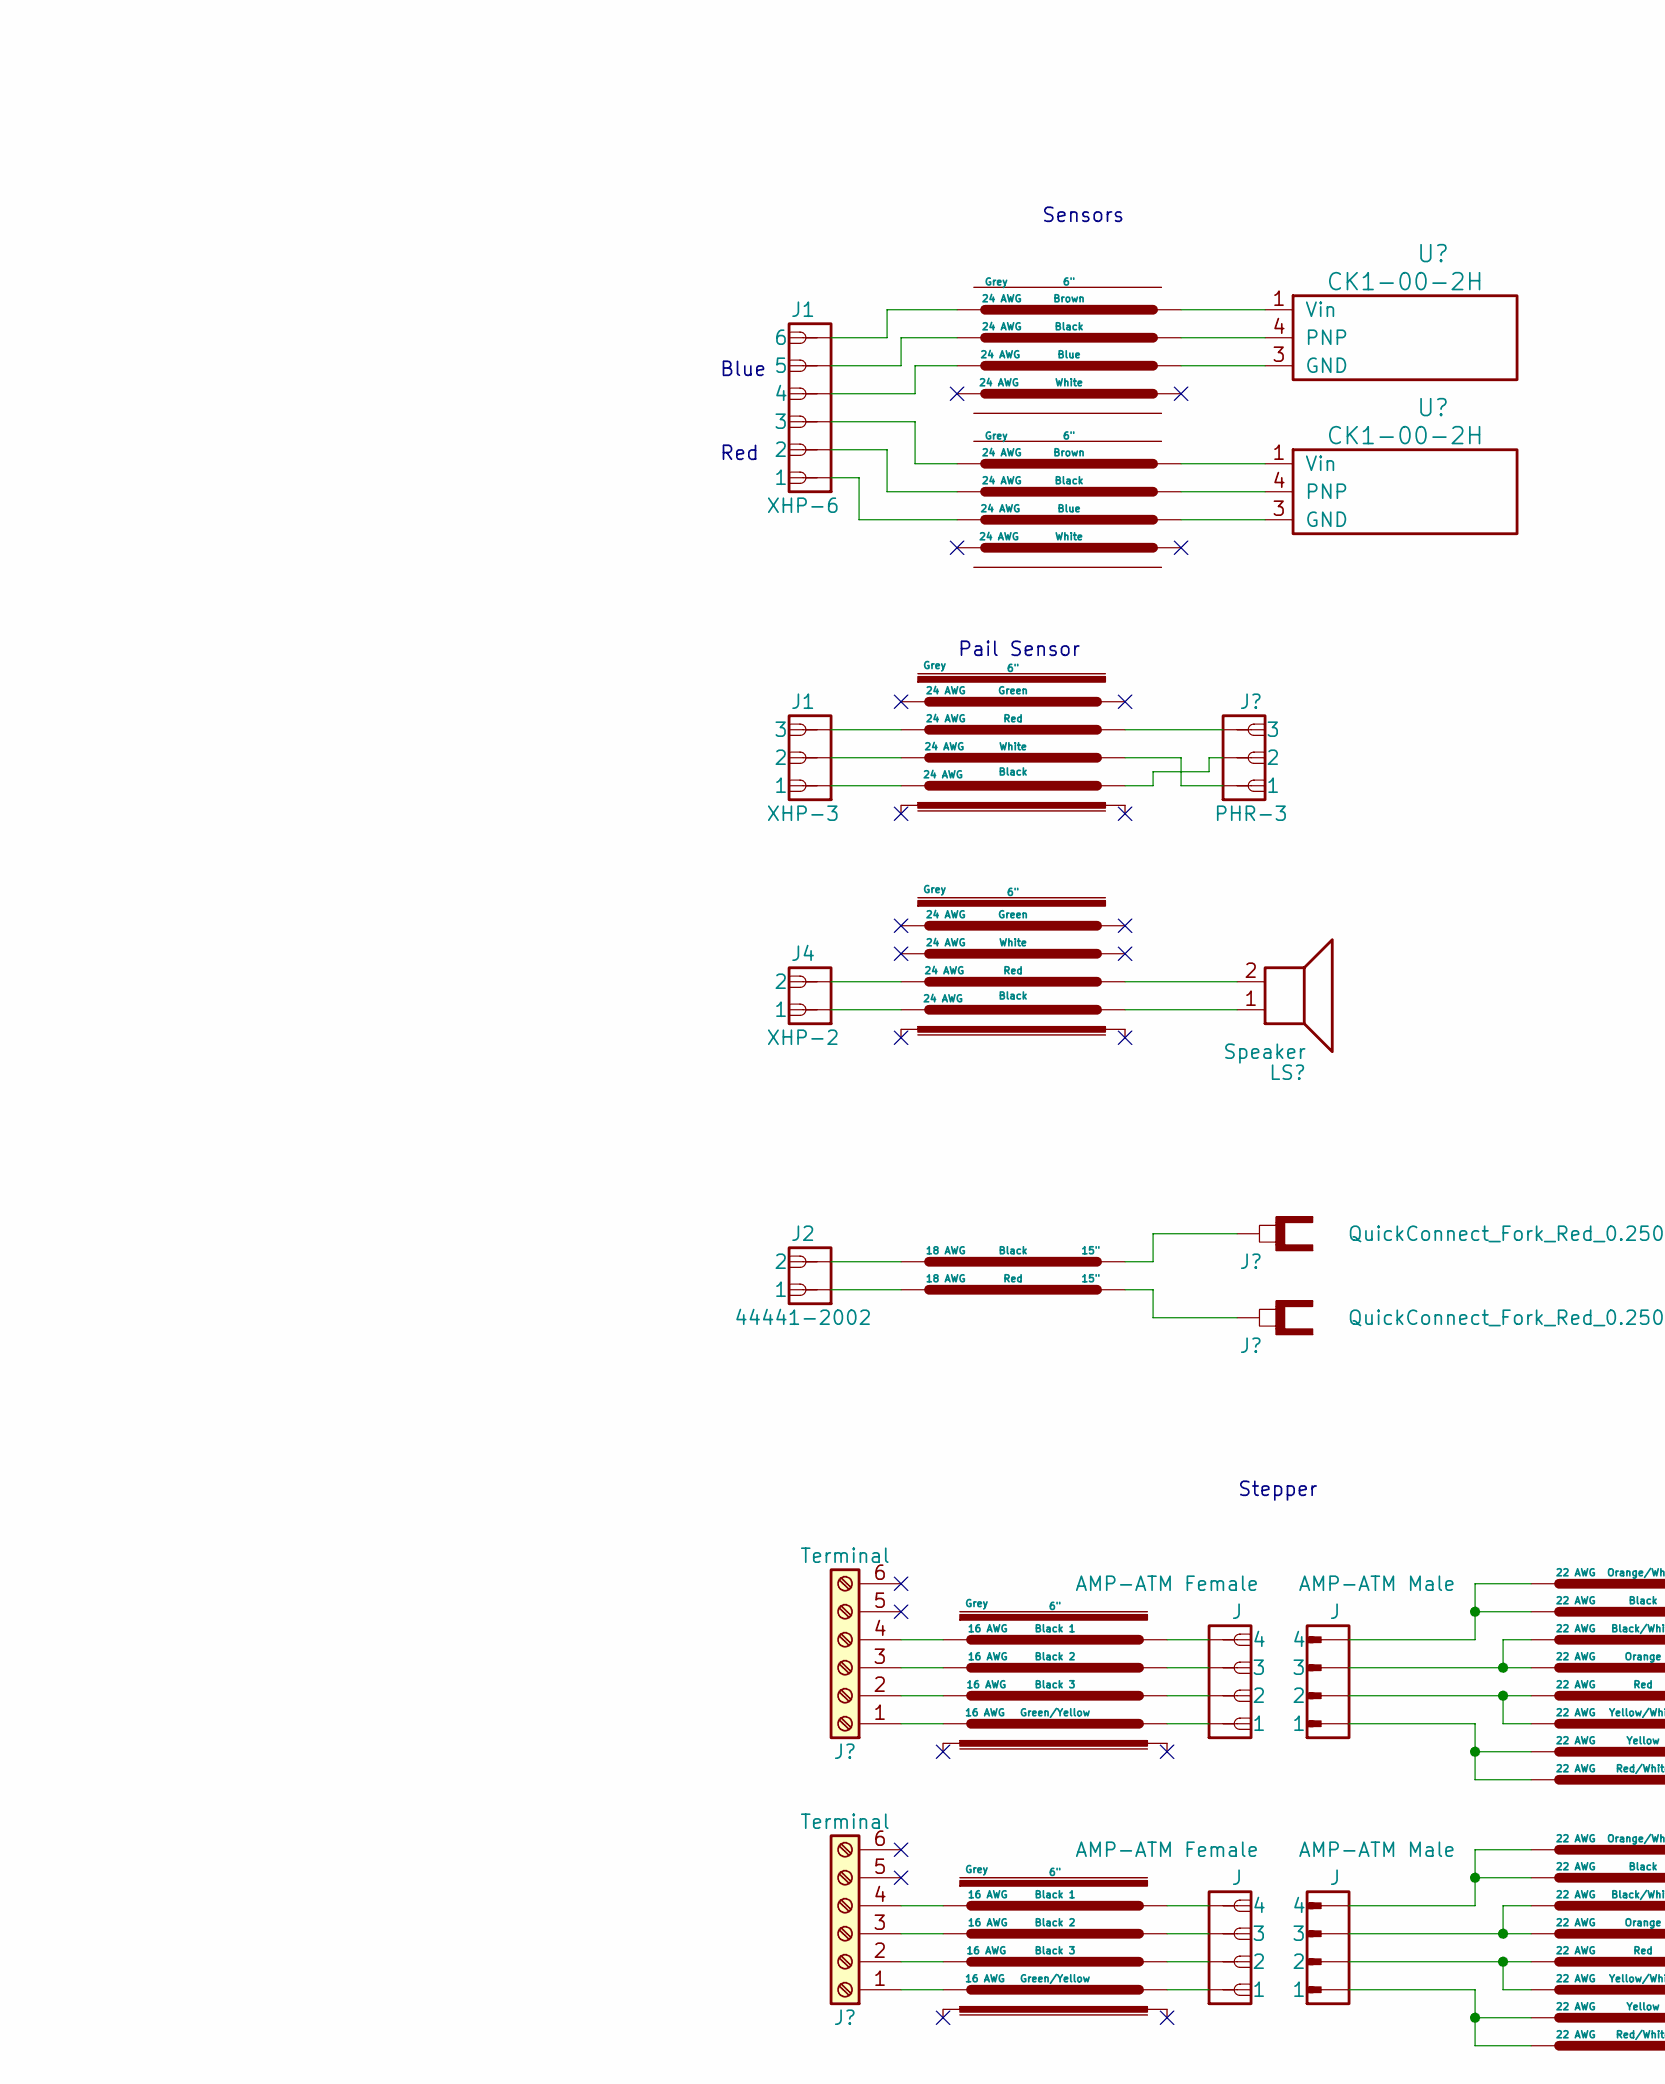
[picture p8: schematic Cable.sch, part in row 2, column 1]

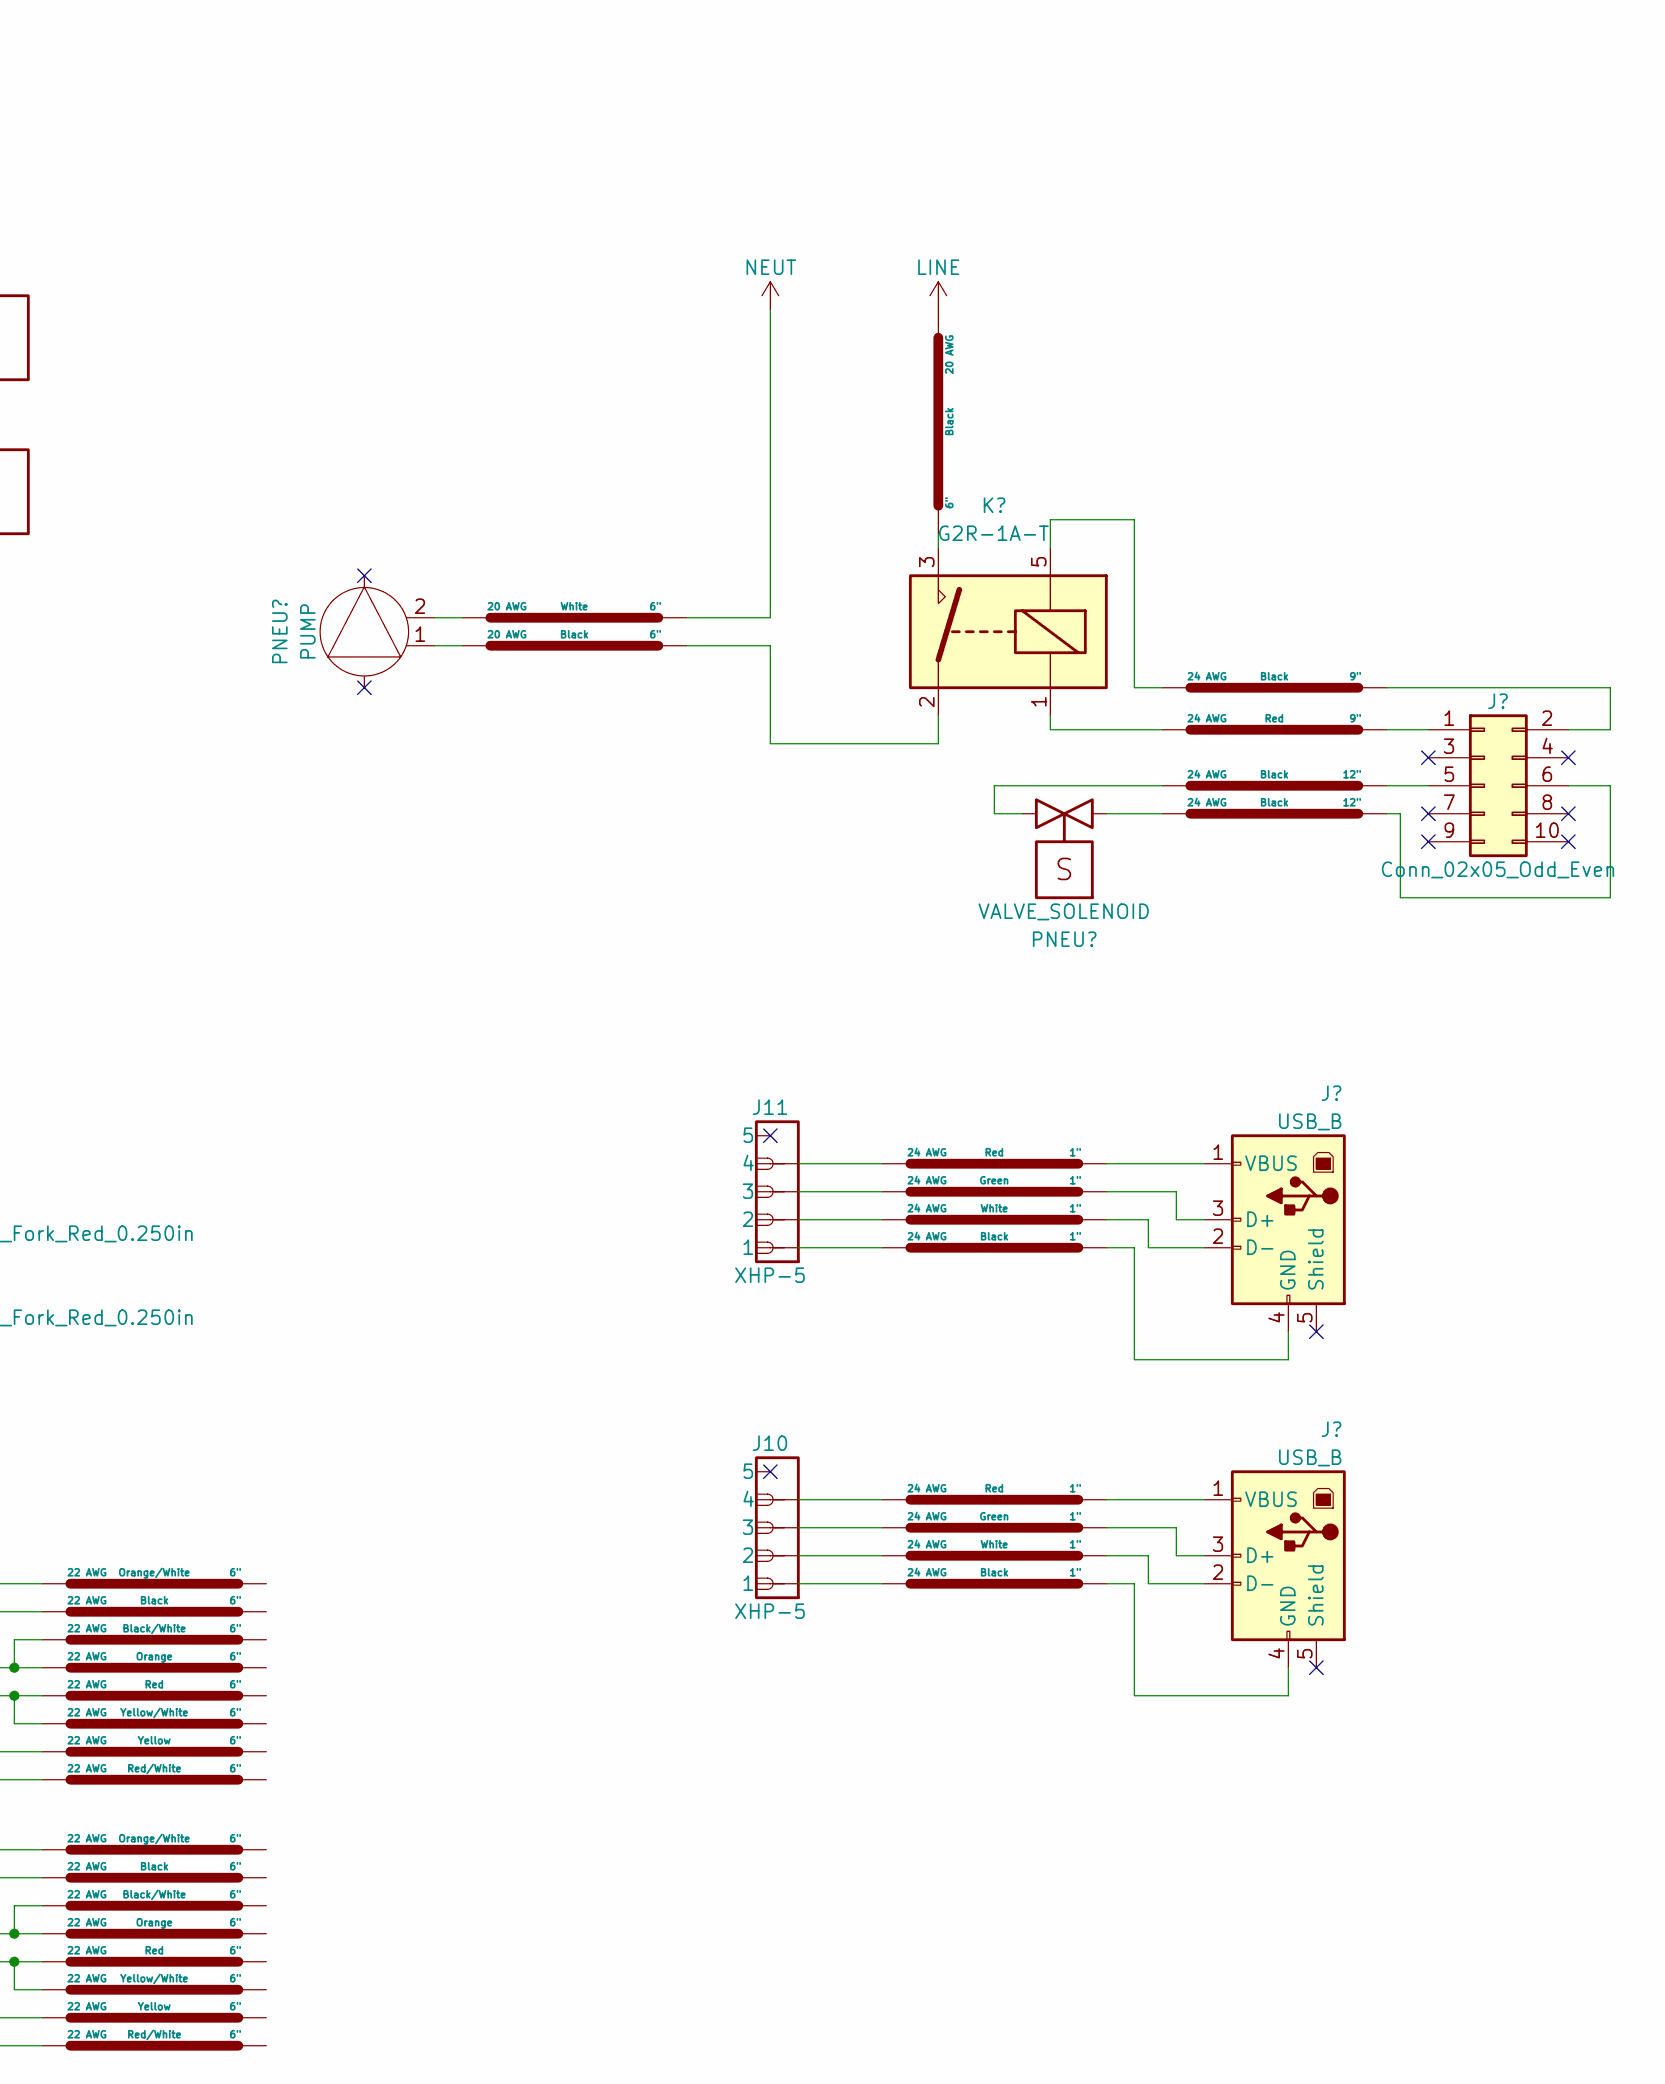
[picture p9: schematic Cable.sch, part in row 2, column 2]

Notes on the sheet:
Sensors
Blue
Red
Pail Sensor
Stepper

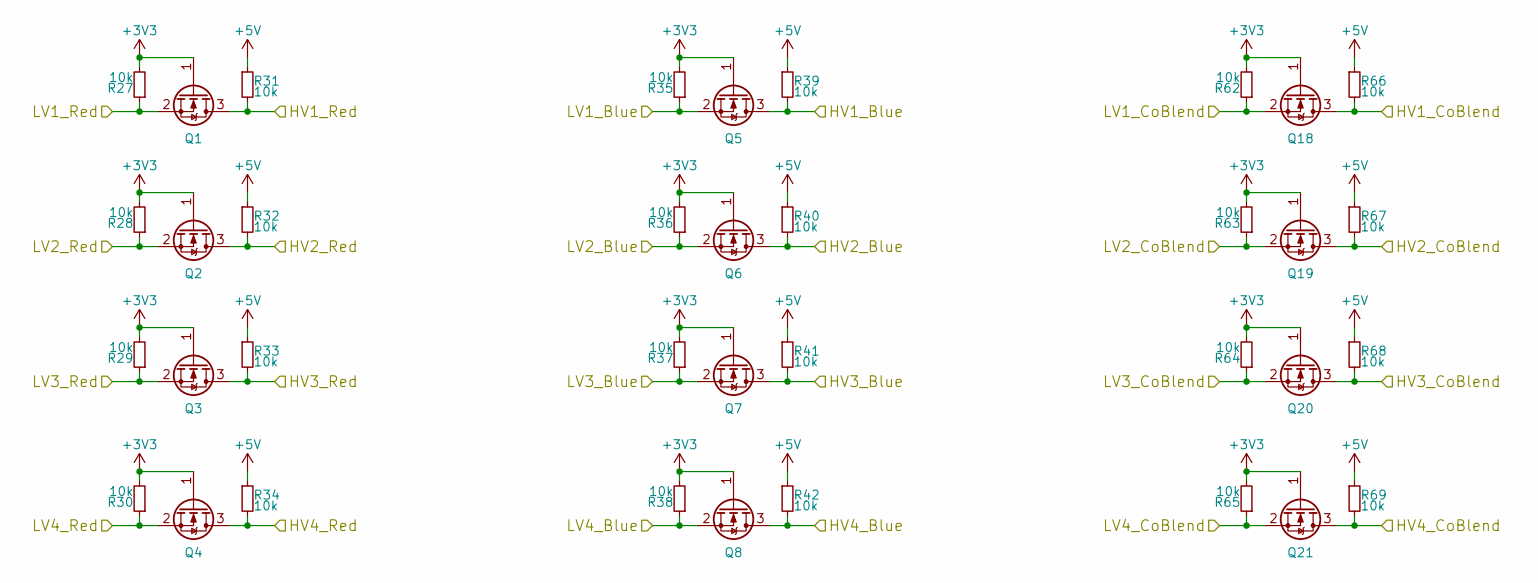
[picture p10: schematic LevelShift.sch]

Parts:
Q1, Q2, Q3, Q4, Q5, Q6, Q7, Q8, Q18, Q19, Q20, Q21: Q_NMOS_GSD; SOT-23; MPN BSS123L
R27, R28, R29, R30, R31, R32, R33, R34, R35, R36, R37, R38, R39, R40, R41, R42, R62, R63, R64, R65, R66, R67, R68, R69: 10k; R_0805_2012Metric_Pad1.15x1.40mm_HandSolder; MPN RMCF0805JG10K0

Connections:
+5V: R31.1, R32.1, R33.1, R34.1, R39.1, R40.1, R41.1, R42.1, R66.1, R67.1, R68.1, R69.1; also elsewhere on the board
Blue_DIR: Q7.3 (D), R41.2; also elsewhere on the board
Blue_DIR_LV: Q7.2 (S), R37.1; also elsewhere on the board
Blue_EN: Q8.3 (D), R42.2; also elsewhere on the board
Blue_EN_LV: Q8.2 (S), R38.1; also elsewhere on the board
Blue_STATUS: Q5.3 (D), R39.2; also elsewhere on the board
Blue_STATUS_LV: Q5.2 (S), R35.1; also elsewhere on the board
Blue_STEP: Q6.3 (D), R40.2; also elsewhere on the board
Blue_STEP_LV: Q6.2 (S), R36.1; also elsewhere on the board
CoBlend_DIR: Q20.3 (D), R68.2; also elsewhere on the board
CoBlend_DIR_LV: Q20.2 (S), R64.1; also elsewhere on the board
CoBlend_EN: Q21.3 (D), R69.2; also elsewhere on the board
CoBlend_EN_LV: Q21.2 (S), R65.1; also elsewhere on the board
CoBlend_STATUS: Q18.3 (D), R66.2; also elsewhere on the board
CoBlend_STATUS_LV: Q18.2 (S), R62.1; also elsewhere on the board
CoBlend_STEP: Q19.3 (D), R67.2; also elsewhere on the board
CoBlend_STEP_LV: Q19.2 (S), R63.1; also elsewhere on the board
Red_DIR: Q3.3 (D), R33.2; also elsewhere on the board
Red_DIR_LV: Q3.2 (S), R29.1; also elsewhere on the board
Red_EN: Q4.3 (D), R34.2; also elsewhere on the board
Red_EN_LV: Q4.2 (S), R30.1; also elsewhere on the board
Red_STATUS: Q1.3 (D), R31.2; also elsewhere on the board
Red_STATUS_LV: Q1.2 (S), R27.1; also elsewhere on the board
Red_STEP: Q2.3 (D), R32.2; also elsewhere on the board
Red_STEP_LV: Q2.2 (S), R28.1; also elsewhere on the board

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
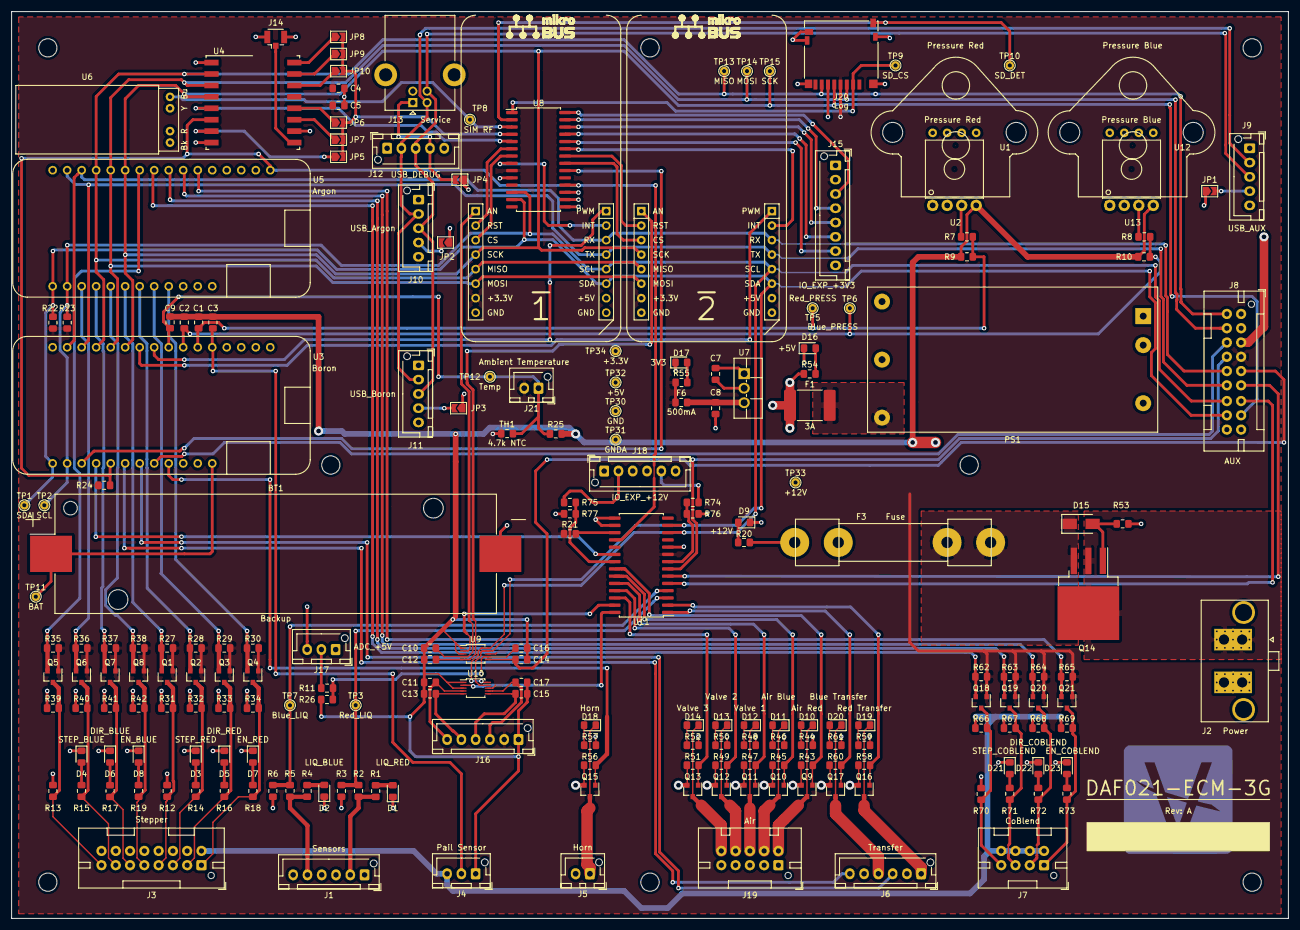
[picture p11: board DAF021_ECM_3G.kicad_pcb from above]

Board: 4 copper layers, 223.5 x 158.8 mm, 207 parts (0 on the bottom side), 138 nets.
