bveenema/DAF021_ECM_3G-Hardware/(commit log)

2020-07-11 Add Cables
    [Cable.sch]
2020-07-11 MotorController interrupt bodge wire
    [DAF021_ECM_3G.sch]
